omjambhale/arduino-plant-waterer/(commit log)

2026-10-02 Add schematic and wiring diagram
2026-10-02 Add Arduino sketch
2026-10-02 Add photo: breadboard and pump
2026-10-02 Add photo: sensor in plant
